AnastasiosKotsadam/Wireless-Charging-with-Mazilli-ZVS/ATmega/atmega328p_connection_schematic.png

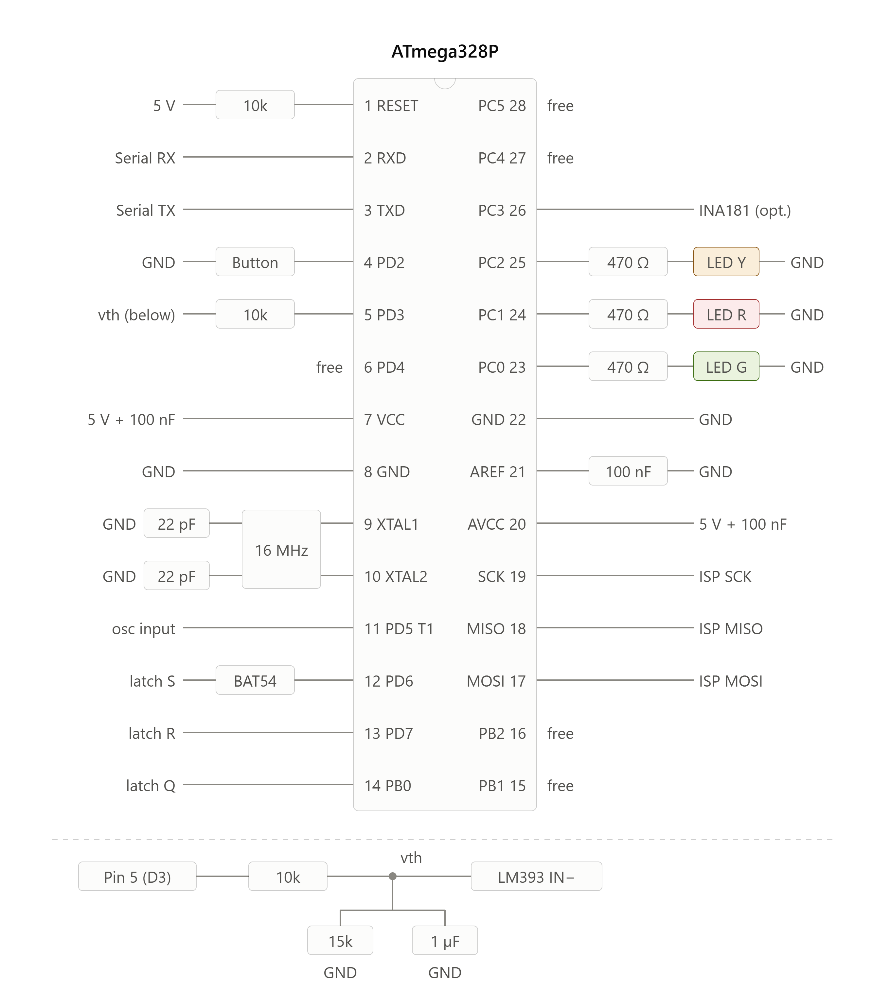
ATmega/atmega328p_connection_schematic.png
