AnastasiosKotsadam/Wireless-Charging-with-Mazilli-ZVS/(list of files, drawings)

Other design files:
ATmega/Microcontroller Setup.sim1
