AnastasiosKotsadam/Wireless-Charging-with-Mazilli-ZVS/Schematic-PCB/WirelessEnergyTransfer.kicad_pcb

## KiCad design Schematic-PCB/WirelessEnergyTransfer.kicad_pcb (2026-11-01)

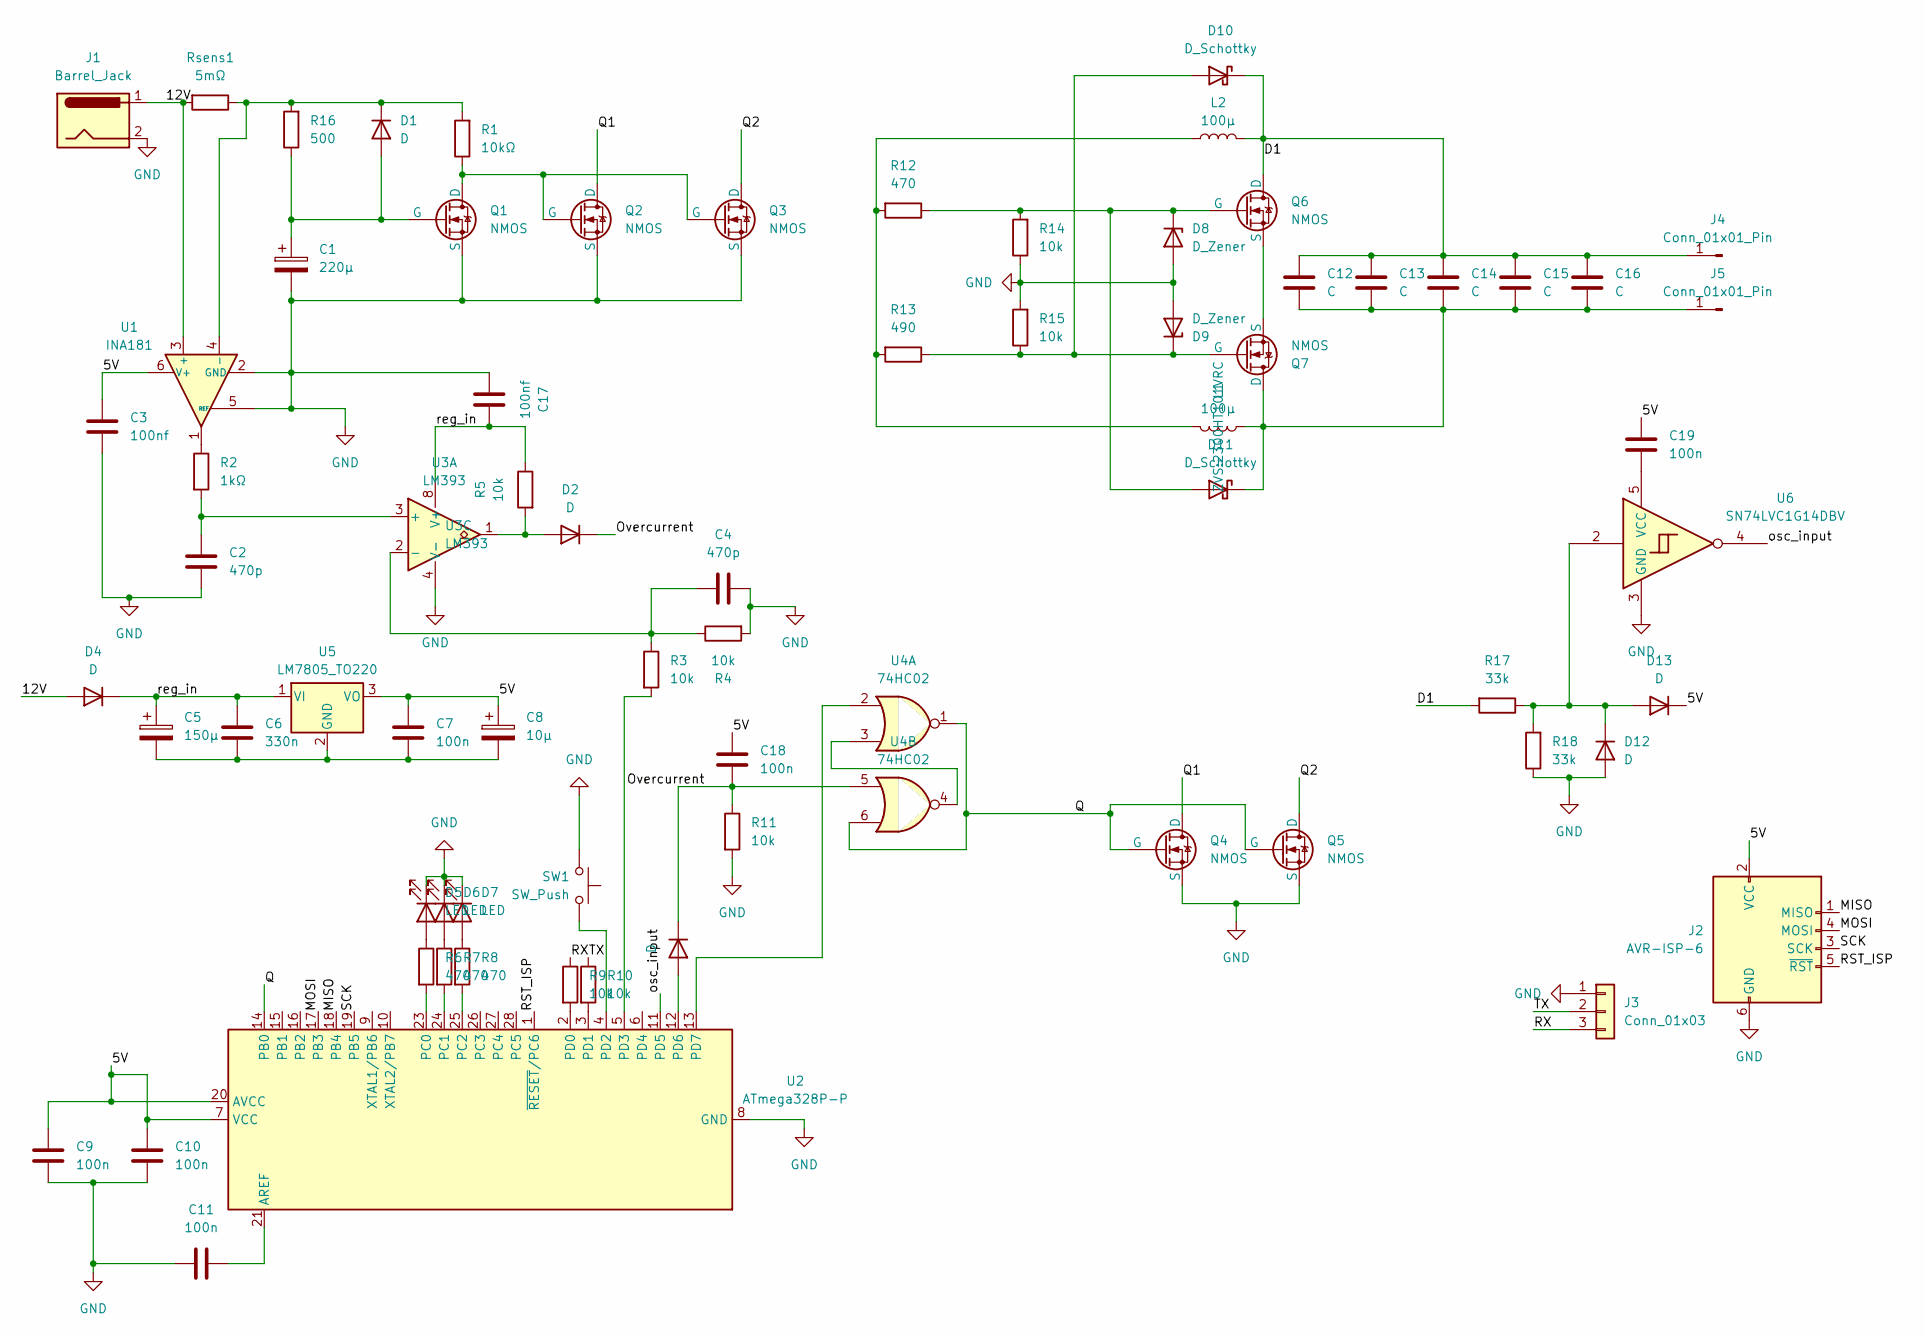
[picture p2: schematic WirelessEnergyTransfer.kicad_sch]

Parts:
C1: 220μ; CP_Radial_D10.0mm_P5.00mm
C2, C4: 470p; C_Axial_L5.1mm_D3.1mm_P7.50mm_Horizontal
C3, C17: 100nf; C_Disc_D10.0mm_W2.5mm_P5.00mm
C5: 150μ; CP_Radial_D10.0mm_P5.00mm
C6: 330n; C_Disc_D10.0mm_W2.5mm_P5.00mm
C7, C9, C10, C11, C18, C19: 100n; C_Disc_D10.0mm_W2.5mm_P5.00mm
C8: 10μ; CP_Radial_D10.0mm_P2.50mm_P5.00mm
C12, C13, C14, C15, C16: C; R76QR32204030J
D1, D4: D; DIOAD3020W130L900D530
D2, D3, D12, D13: D; D_DO-35_SOD27_P10.16mm_Horizontal
D5, D6, D7: LED; LED_D3.0mm_IRBlack
D8, D9: D_Zener; DIOAD1413W86L463D238
D10, D11: D_Schottky; DIOAD3020W130L900D530
J1: Barrel_Jack; BarrelJack_Horizontal
J2: AVR-ISP-6; IDC-Header_2x03_P2.54mm_Horizontal
J3: Conn_01x03; PinSocket_1x03_P2.54mm_Horizontal
J4, J5: Conn_01x01_Pin; TestPoint_Pad_4.0x4.0mm
L1, L2: 100μ; 2300HT101VRC
Q1, Q2, Q3, Q4, Q5: NMOS; 2N3904BU
Q6, Q7: NMOS; TO254P465X1028X1970-3P
R1: 10kΩ; R_Axial_DIN0309_L9.0mm_D3.2mm_P12.70mm_Horizontal
R2: 1kΩ; R_Axial_DIN0309_L9.0mm_D3.2mm_P12.70mm_Horizontal
R3, R4, R5, R9, R10, R11: 10k; R_Axial_DIN0309_L9.0mm_D3.2mm_P12.70mm_Horizontal
R6, R7, R8: 470; R_Axial_DIN0309_L9.0mm_D3.2mm_P12.70mm_Horizontal
R12: 470; R_Axial_DIN0411_L9.9mm_D3.6mm_P15.24mm_Horizontal
R13: 490; R_Axial_DIN0411_L9.9mm_D3.6mm_P15.24mm_Horizontal
R14, R15: 10k; R_Axial_DIN0411_L9.9mm_D3.6mm_P15.24mm_Horizontal
R16: 500; R_Axial_DIN0411_L9.9mm_D3.6mm_P15.24mm_Horizontal
R17, R18: 33k; R_Axial_DIN0309_L9.0mm_D3.2mm_P12.70mm_Horizontal
Rsens1: 5mΩ; R_Axial_DIN0411_L9.9mm_D3.6mm_P15.24mm_Horizontal
SW1: SW_Push; SW_CW_GPTS203211B
U1: INA181; SOT-23-6
U2: ATmega328P-P; DIP-28_W7.62mm
U3: LM393; PS8
U4: 74HC02; DIP-10_W7.62mm
U5: LM7805_TO220; TO-220-3_Vertical
U6: SN74LVC1G14DBV; SOT-23-5

Connections:
/5V: C3.1, C7.2, C8.1, C9.2, C10.2, C18.2, C19.2, D13.1 (K), J2.2 (VCC), U1.6 (V+), U2.7 (VCC), U2.20 (AVCC), U5.3 (VO)
/12V: D4.2 (A), J1.1, Rsens1.2, U1.3 (+)
/D1: C12.1, C13.1, C14.1, C15.1, C16.1, D10.1 (K), J4.1 (Pin_1_1), L2.1, Q6.1 (D), R17.2
/MISO: J2.1 (MISO), U2.18 (PB4)
/MOSI: J2.4 (MOSI), U2.17 (PB3)
/Overcurrent: C18.1, D2.1 (K), D3.1 (K), R11.1, U4.5
/Q: Q4.2 (G), Q5.2 (G), U2.14 (PB0), U4.1, U4.6
/Q1: Q2.1 (D), Q4.1 (D)
/Q2: Q3.1 (D), Q5.1 (D)
/RST_ISP: J2.5 (~RST), U2.1 (~RESET/PC6)
/RX: J3.3, R9.1
/SCK: J2.3 (SCK), U2.19 (PB5)
/TX: J3.2, R10.1
/osc_input: U2.11 (PD5), U6.4
/reg_in: C5.1, C6.2, C17.2, D4.1 (K), R5.1, U3.8 (V+), U5.1 (VI)
GND: C1.2, C2.1, C3.2, C4.1, C9.1, C10.1, C11.1, C17.1, D5.1 (K), D6.1 (K), D7.1 (K), D8.2 (A), D9.2 (A), D12.2 (A), J1.2, J2.6 (GND), J3.1, Q1.3 (S), Q2.3 (S), Q3.3 (S), Q4.3 (S), Q5.3 (S), R4.2, R11.2, R14.1, R15.2, R18.1, SW1.2, U1.2 (GND), U1.5 (REF), U2.8 (GND), U2.22 (GND), U3.4 (V-), U6.3 (GND)
unnamed: C1.1, D1.2 (A), Q1.2 (G), R16.1
unnamed: D1.1 (K), R1.2, R16.2, Rsens1.1, U1.4 (-)
unnamed: D2.2 (A), R5.2, U3.1
unnamed: D3.2 (A), U2.12 (PD6)
unnamed: D5.2 (A), R6.1
unnamed: D6.2 (A), R7.1
unnamed: D7.2 (A), R8.1
unnamed: D9.1 (K), D10.2 (A), Q7.2 (G), R13.1, R15.1
unnamed: D8.1 (K), D11.2 (A), Q6.2 (G), R12.1, R14.2
unnamed: C12.2, C13.2, C14.2, C15.2, C16.2, D11.1 (K), J5.1 (Pin_1_1), L1.1, Q7.1 (D)
unnamed: D12.1 (K), D13.2 (A), R17.1, R18.2, U6.2
unnamed: L1.2, L2.2, R12.2, R13.2
unnamed: Q1.1 (D), Q2.2 (G), Q3.2 (G), R1.1
unnamed: Q6.3 (S), Q7.3 (S)
unnamed: R2.1, U1.1
unnamed: C11.2, U2.21 (AREF)
unnamed: R6.2, U2.23 (PC0)
unnamed: R7.2, U2.24 (PC1)
unnamed: R8.2, U2.25 (PC2)
unnamed: R9.2, U2.2 (PD0)
unnamed: R10.2, U2.3 (PD1)
unnamed: SW1.1, U2.4 (PD2)
unnamed: R3.2, U2.5 (PD3)
unnamed: U2.13 (PD7), U4.2
unnamed: C2.2, R2.2, U3.3 (+)
unnamed: C4.2, R3.1, R4.1, U3.2 (-)
unnamed: U4.3, U4.4
unnamed: C5.2, C6.1, C7.1, C8.2, U5.2 (GND)
unnamed: C19.1, U6.5 (VCC)

Board: 2 copper layers, 72 parts (0 on the bottom side), 45 nets, no tracks yet.
